jasonsckrabulis/mcwhinnie_etal_respirometry/(threads)

Thread 3 (2023-12-27):

Incorrect diagram

jasonsckrabulis, 2023-12-27:
When commisioning a custom PCB, the designer discovered an incorrect diagram that was correctly _implemented_ in production and in the publication.
